telehua/NotLink_v6/docs/SCH_NotLink_v6_0.pdf

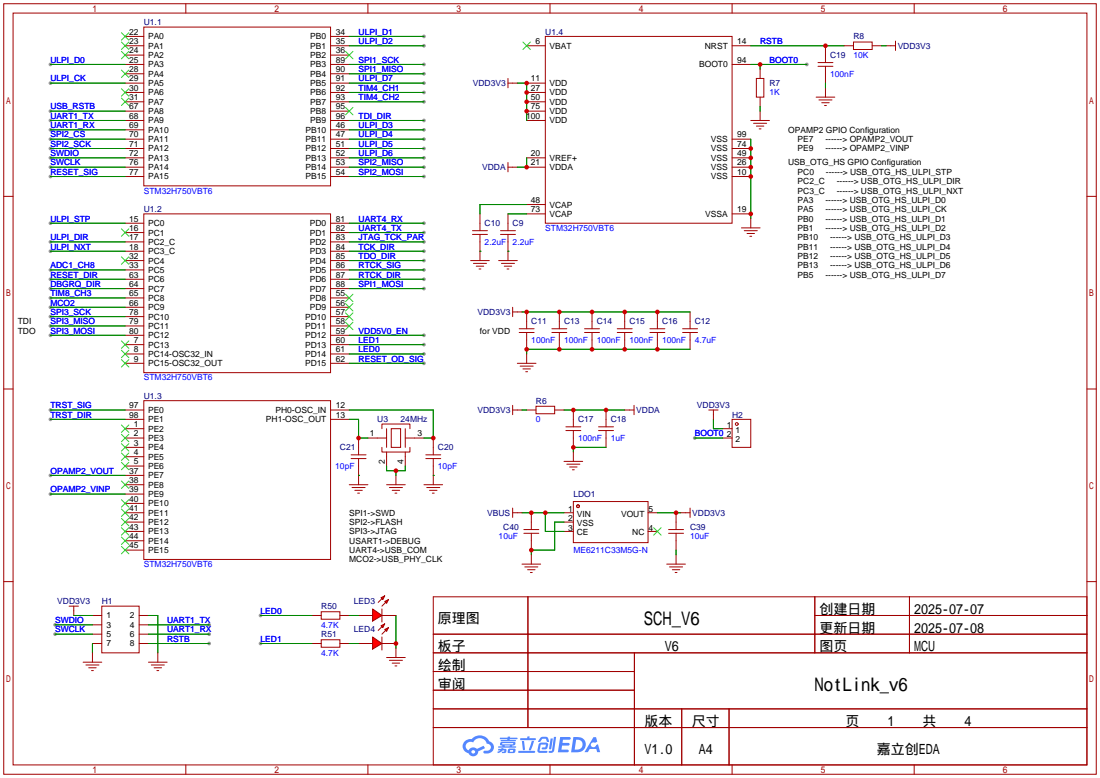
[picture p1: page 1]

原理图 | SCH_V6 | 创建日期 | 2025-07-07

更新日期 | 2025-07-08

板子 | V6 | 图页 | MCU
绘制 | | NotLink_v6
审阅

V1.0 | A4 | 嘉立创EDA

# XI 28 VDDA¹⁸ ²⁹

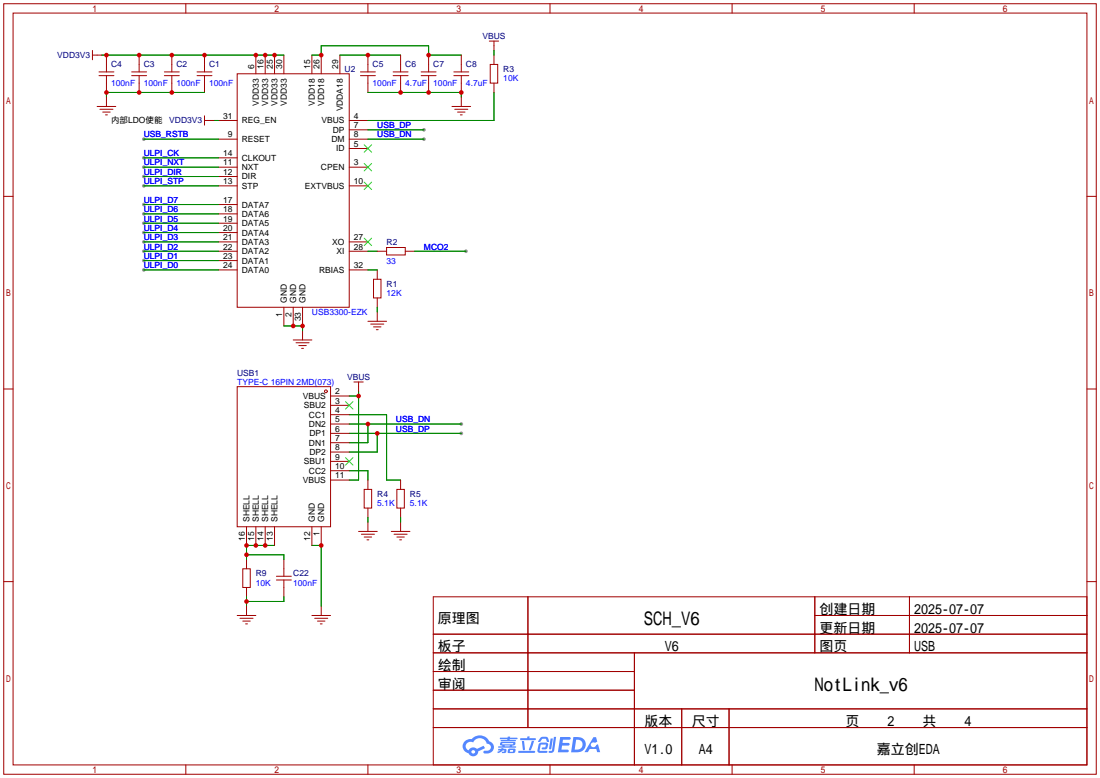
[picture p2: page 2]

SHELL 13 SHELL 14 SHELL 15 SHELL 16

原理图 | SCH_V6 | 创建日期 | 2025-07-07

更新日期 | 2025-07-07

板子 | V6 | 图页 | USB
绘制 | | NotLink_v6
审阅

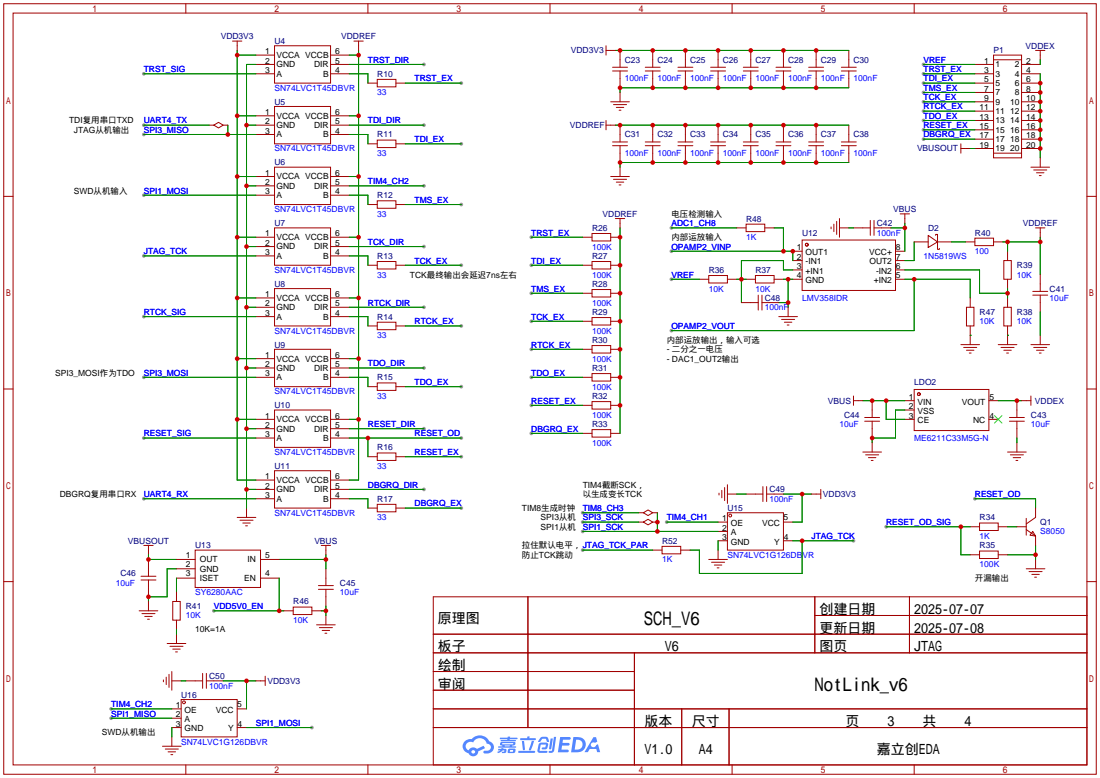
[picture p3: page 3]

原理图 | SCH_V6 | 创建日期 | 2025-07-07

更新日期 | 2025-07-08

板子 | V6 | 图页 | JTAG
绘制 | | NotLink_v6
审阅

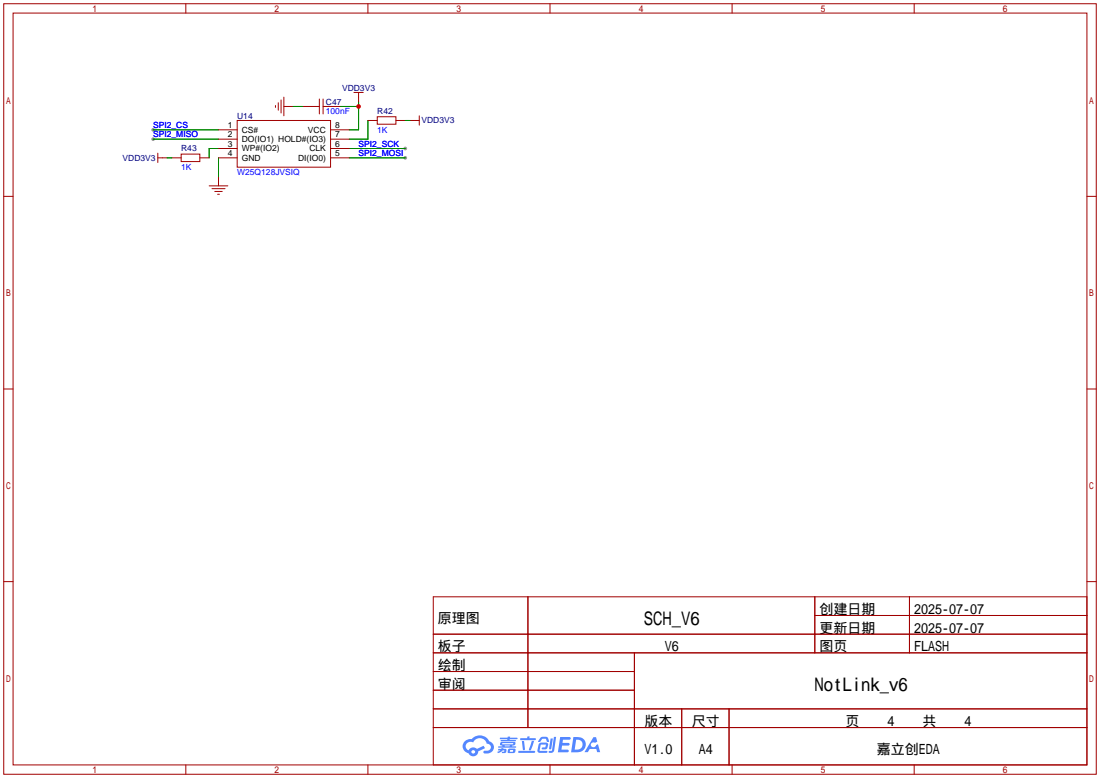
[picture p4: page 4]

原理图 | SCH_V6 | 创建日期 | 2025-07-07

更新日期 | 2025-07-07

板子 | V6 | 图页 | FLASH
绘制 | | NotLink_v6
审阅
