telehua/NotLink_v6/source/dap/dap.h

/*
 * Copyright (c) 2013-2022 ARM Limited. All rights reserved.
 *
 * SPDX-License-Identifier: Apache-2.0
 *
 * Licensed under the Apache License, Version 2.0 (the License); you may
 * not use this file except in compliance with the License.
 * You may obtain a copy of the License at
 *
 * www.apache.org/licenses/LICENSE-2.0
 *
 * Unless required by applicable law or agreed to in writing, software
 * distributed under the License is distributed on an AS IS BASIS, WITHOUT
 * WARRANTIES OR CONDITIONS OF ANY KIND, either express or implied.
 * See the License for the specific language governing permissions and
 * limitations under the License.
 *
 * ----------------------------------------------------------------------
 *
 * $Date:        5. December 2022
 * $Revision:    V2.1.2
 *
 * Project:      CMSIS-DAP Include
 * Title:        dap.h Definitions
 *
 *---------------------------------------------------------------------------*/

#ifndef __DAP_H__
#define __DAP_H__

// clang-format off

// DAP Firmware Version
#ifdef DAP_FW_V1
#define DAP_FW_VER "1.3.0"
#else
#define DAP_FW_VER "2.1.2"
#endif

// DAP Command IDs
#define ID_DAP_Info                 0x00U // 获取设备信息
#define ID_DAP_HostStatus           0x01U // 设定LED状态
#define ID_DAP_Connect              0x02U // 打开接口
#define ID_DAP_Disconnect           0x03U // 关闭接口
#define ID_DAP_TransferConfigure    0x04U // 配置传输参数
#define ID_DAP_Transfer             0x05U // 传输
#define ID_DAP_TransferBlock        0x06U // 块传输
#define ID_DAP_TransferAbort        0x07U // 
#define ID_DAP_WriteABORT           0x08U // 写停止寄存器
#define ID_DAP_Delay                0x09U // 延时
#define ID_DAP_ResetTarget          0x0AU // 复位目标芯片
#define ID_DAP_SWJ_Pins             0x10U // 软件IO设置
#define ID_DAP_SWJ_Clock            0x11U // 时钟速度
#define ID_DAP_SWJ_Sequence         0x12U // 序列
#define ID_DAP_SWD_Configure        0x13U // SWD配置
#define ID_DAP_SWD_Sequence         0x1DU // SWD序列
#define ID_DAP_JTAG_Sequence        0x14U // JTAG序列
#define ID_DAP_JTAG_Configure       0x15U // JTAG配置
#define ID_DAP_JTAG_IDCODE          0x16U // JTAG读IDCODE
#define ID_DAP_SWO_Transport        0x17U // 
#define ID_DAP_SWO_Mode             0x18U // 
#define ID_DAP_SWO_Baudrate         0x19U // 
#define ID_DAP_SWO_Control          0x1AU // 
#define ID_DAP_SWO_Status           0x1BU // 
#define ID_DAP_SWO_ExtendedStatus   0x1EU // 
#define ID_DAP_SWO_Data             0x1CU // 
#define ID_DAP_UART_Transport       0x1FU // 
#define ID_DAP_UART_Configure       0x20U // 
#define ID_DAP_UART_Control         0x22U // 
#define ID_DAP_UART_Status          0x23U // 
#define ID_DAP_UART_Transfer        0x21U // 

#define ID_DAP_QueueCommands        0x7EU // 顺序执行个操作
#define ID_DAP_ExecuteCommands      0x7FU // 执行单个操作

// DAP Vendor Command IDs
#define ID_DAP_Vendor0      0x80U
#define ID_DAP_Vendor1      0x81U
#define ID_DAP_Vendor2      0x82U
#define ID_DAP_Vendor3      0x83U
#define ID_DAP_Vendor4      0x84U
#define ID_DAP_Vendor5      0x85U
#define ID_DAP_Vendor6      0x86U
#define ID_DAP_Vendor7      0x87U
#define ID_DAP_Vendor8      0x88U
#define ID_DAP_Vendor9      0x89U
#define ID_DAP_Vendor10     0x8AU
#define ID_DAP_Vendor11     0x8BU
#define ID_DAP_Vendor12     0x8CU
#define ID_DAP_Vendor13     0x8DU
#define ID_DAP_Vendor14     0x8EU
#define ID_DAP_Vendor15     0x8FU
#define ID_DAP_Vendor16     0x90U
#define ID_DAP_Vendor17     0x91U
#define ID_DAP_Vendor18     0x92U
#define ID_DAP_Vendor19     0x93U
#define ID_DAP_Vendor20     0x94U
#define ID_DAP_Vendor21     0x95U
#define ID_DAP_Vendor22     0x96U
#define ID_DAP_Vendor23     0x97U
#define ID_DAP_Vendor24     0x98U
#define ID_DAP_Vendor25     0x99U
#define ID_DAP_Vendor26     0x9AU
#define ID_DAP_Vendor27     0x9BU
#define ID_DAP_Vendor28     0x9CU
#define ID_DAP_Vendor29     0x9DU
#define ID_DAP_Vendor30     0x9EU
#define ID_DAP_Vendor31     0x9FU

#define ID_DAP_Invalid      0xFFU

// DAP Status Code
#define DAP_OK      0U
#define DAP_ERROR   0xFFU

// DAP ID
#define DAP_ID_VENDOR               0x01U // 厂家
#define DAP_ID_PRODUCT              0x02U // 产品
#define DAP_ID_SER_NUM              0x03U // 序列号
#define DAP_ID_DAP_FW_VER           0x04U // 固件版本
#define DAP_ID_DEVICE_VENDOR        0x05U // 设备厂家
#define DAP_ID_DEVICE_NAME          0x06U // 设备名
#define DAP_ID_BOARD_VENDOR         0x07U // 板厂家
#define DAP_ID_BOARD_NAME           0x08U // 板名
#define DAP_ID_PRODUCT_FW_VER       0x09U // 产品版本
#define DAP_ID_CAPABILITIES         0xF0U // 可用功能
#define DAP_ID_TIMESTAMP_CLOCK      0xF1U // 时间戳计数频率
#define DAP_ID_UART_RX_BUFFER_SIZE  0xFBU // UART接收缓冲区大小
#define DAP_ID_UART_TX_BUFFER_SIZE  0xFCU // UART发送缓冲区大小
#define DAP_ID_SWO_BUFFER_SIZE      0xFDU // SWO缓冲区大小
#define DAP_ID_PACKET_COUNT         0xFEU // 包缓存个数
#define DAP_ID_PACKET_SIZE          0xFFU // 最大包长

// DAP Host Status
#define DAP_DEBUGGER_CONNECTED  0U
#define DAP_TARGET_RUNNING      1U

// DAP Port
#define DAP_PORT_AUTODETECT     0U // 自动 Autodetect Port 
#define DAP_PORT_DISABLED       0U // 高阻 Port Disabled (I/O pins in High-Z) 
#define DAP_PORT_SWD            1U // SWD Port (SWCLK, SWDIO) + nRESET
#define DAP_PORT_JTAG           2U // JTAG Port (TCK, TMS, TDI, TDO, nTRST) + nRESET

// DAP SWJ Pins
#define DAP_SWJ_SWCLK_TCK   0 // SWCLK/TCK
#define DAP_SWJ_SWDIO_TMS   1 // SWDIO/TMS
#define DAP_SWJ_TDI         2 // TDI
#define DAP_SWJ_TDO         3 // TDO
#define DAP_SWJ_nTRST       5 // nTRST
#define DAP_SWJ_nRESET      7 // nRESET

// DAP Transfer Request
#define DAP_TRANSFER_APnDP          (1U << 0)
#define DAP_TRANSFER_RnW            (1U << 1)
#define DAP_TRANSFER_A2             (1U << 2)
#define DAP_TRANSFER_A3             (1U << 3)
#define DAP_TRANSFER_MATCH_VALUE    (1U << 4)
#define DAP_TRANSFER_MATCH_MASK     (1U << 5)
#define DAP_TRANSFER_TIMESTAMP      (1U << 7)

// DAP Transfer Response
#define DAP_TRANSFER_OK         (1U << 0)
#define DAP_TRANSFER_WAIT       (1U << 1)
#define DAP_TRANSFER_FAULT      (1U << 2)
#define DAP_TRANSFER_ERROR      (1U << 3)
#define DAP_TRANSFER_MISMATCH   (1U << 4)

// DAP SWO Trace Mode
#define DAP_SWO_OFF         0U
#define DAP_SWO_UART        1U
#define DAP_SWO_MANCHESTER  2U

// DAP SWO Trace Status
#define DAP_SWO_CAPTURE_ACTIVE  (1U << 0)
#define DAP_SWO_CAPTURE_PAUSED  (1U << 1)
#define DAP_SWO_STREAM_ERROR    (1U << 6)
#define DAP_SWO_BUFFER_OVERRUN  (1U << 7)

// DAP UART Transport
#define DAP_UART_TRANSPORT_NONE         0U
#define DAP_UART_TRANSPORT_USB_COM_PORT 1U
#define DAP_UART_TRANSPORT_DAP_COMMAND  2U

// DAP UART Control
#define DAP_UART_CONTROL_RX_ENABLE      (1U << 0)
#define DAP_UART_CONTROL_RX_DISABLE     (1U << 1)
#define DAP_UART_CONTROL_RX_BUF_FLUSH   (1U << 2)
#define DAP_UART_CONTROL_TX_ENABLE      (1U << 4)
#define DAP_UART_CONTROL_TX_DISABLE     (1U << 5)
#define DAP_UART_CONTROL_TX_BUF_FLUSH   (1U << 6)

// DAP UART Status
#define DAP_UART_STATUS_RX_ENABLED      (1U << 0)
#define DAP_UART_STATUS_RX_DATA_LOST    (1U << 1)
#define DAP_UART_STATUS_FRAMING_ERROR   (1U << 2)
#define DAP_UART_STATUS_PARITY_ERROR    (1U << 3)
#define DAP_UART_STATUS_TX_ENABLED      (1U << 4)

// DAP UART Configure Error
#define DAP_UART_CFG_ERROR_DATA_BITS    (1U << 0)
#define DAP_UART_CFG_ERROR_PARITY       (1U << 1)
#define DAP_UART_CFG_ERROR_STOP_BITS    (1U << 2)

// Debug Port Register Addresses
#define DP_IDCODE           0x00U // IDCODE Register (SW Read only)
#define DP_ABORT            0x00U // Abort Register (SW Write only)
#define DP_CTRL_STAT        0x04U // Control & Status
#define DP_WCR              0x04U // Wire Control Register (SW Only)
#define DP_SELECT           0x08U // Select Register (JTAG R/W & SW W)
#define DP_RESEND           0x08U // Resend (SW Read Only)
#define DP_RDBUFF           0x0CU // Read Buffer (Read Only)

// JTAG IR Codes
#define JTAG_ABORT          0x08U
#define JTAG_DPACC          0x0AU
#define JTAG_APACC          0x0BU
#define JTAG_IDCODE         0x0EU
#define JTAG_BYPASS         0x0FU

// JTAG Sequence Info
#define JTAG_SEQUENCE_TCK   0x3FU // TCK count
#define JTAG_SEQUENCE_TMS   0x40U // TMS value
#define JTAG_SEQUENCE_TDO   0x80U // TDO capture

// SWD Sequence Info
#define SWD_SEQUENCE_CLK    0x3FU // SWCLK count
#define SWD_SEQUENCE_DIN    0x80U // SWDIO capture

// clang-format on

#include <stdbool.h>
#include <stddef.h>
#include <stdint.h>
#include <stdlib.h>

#include "cmsis_compiler.h"
#include "dap_config.h"

// clang-format off

// DAP Data structure
typedef struct
{
    uint32_t debug_port;    // 接口 Debug Port
    uint32_t clock_delay;   // Clock Delay
    uint32_t timestamp;     // 时间戳 Last captured Timestamp
    uint32_t gpio_mode;     // GPIO模式
    struct
    {                           // 传输配置 Transfer Configuration
        uint32_t idle_cycles;   // 传输后生成的空闲周期数(最大值255) Idle cycles after transfer
        uint32_t retry_count;   // ACK忙时重试次数(最大65535) Number of retries after WAIT response
        uint32_t match_retry;   // 匹配模式时重试次数(最大65535) Number of retries if read value does not match
        uint32_t match_mask;    // 匹配模式的掩码 Match Mask
    } transfer;
#if (DAP_SWD != 0)
    struct                      
    {                           // SWD配置 SWD Configuration
        uint32_t turnaround;    // 方向转换时插入的周期数(最大值4) Turnaround period
        uint32_t data_phase;    // 是否始终生成数据阶段 Always generate Data Phase
    } swd_conf;
#endif
#if (DAP_JTAG != 0)
    struct
    {                       // JTAG Device Chain
        uint32_t count;     // 线上的设备个数 Number of devices
        uint32_t index;     // 设备位置 Device index (device at TDO has index 0)
#if (DAP_JTAG_DEV_CNT != 0)
        uint32_t ir_length[DAP_JTAG_DEV_CNT];   // 每个设备的IR长度(255 max) IR Length in bits
        uint32_t ir_before[DAP_JTAG_DEV_CNT];   // 设备前方的IR长度 Bits before IR
        uint32_t ir_after[DAP_JTAG_DEV_CNT];    // 设备后方的IR长度 Bits after IR
#endif
    } jtag_dev;
#endif
} dap_data_t;

// clang-format on

extern dap_data_t dap_data;                 // DAP Data
extern volatile uint8_t dap_transfer_abort; // Transfer Abort Flag

#ifdef __cplusplus
extern "C"
{
#endif

#if (SWO_UART != 0)
    extern uint32_t SWO_Transport(const uint8_t *request, uint8_t *response);
    extern uint32_t SWO_Mode(const uint8_t *request, uint8_t *response);
    extern uint32_t SWO_Baudrate(const uint8_t *request, uint8_t *response);
    extern uint32_t SWO_Control(const uint8_t *request, uint8_t *response);
    extern uint32_t SWO_Status(uint8_t *response);
    extern uint32_t SWO_ExtendedStatus(const uint8_t *request, uint8_t *response);
    extern uint32_t SWO_Data(const uint8_t *request, uint8_t *response);

    extern void SWO_QueueTransfer(uint8_t *buf, uint32_t num);
    extern void SWO_AbortTransfer(void);
    extern void SWO_TransferComplete(void);

    extern uint32_t SWO_Mode_UART(uint32_t enable);
    extern uint32_t SWO_Baudrate_UART(uint32_t baudrate);
    extern uint32_t SWO_Control_UART(uint32_t active);
    extern void SWO_Capture_UART(uint8_t *buf, uint32_t num);
    extern uint32_t SWO_GetCount_UART(void);

    extern uint32_t SWO_Mode_Manchester(uint32_t enable);
    extern uint32_t SWO_Baudrate_Manchester(uint32_t baudrate);
    extern uint32_t SWO_Control_Manchester(uint32_t active);
    extern void SWO_Capture_Manchester(uint8_t *buf, uint32_t num);
    extern uint32_t SWO_GetCount_Manchester(void);
#endif

#if (DAP_UART != 0)
    extern uint32_t UART_Transport(const uint8_t *request, uint8_t *response);
    extern uint32_t UART_Configure(const uint8_t *request, uint8_t *response);
    extern uint32_t UART_Control(const uint8_t *request, uint8_t *response);
    extern uint32_t UART_Status(uint8_t *response);
    extern uint32_t UART_Transfer(const uint8_t *request, uint8_t *response);
    extern uint8_t USB_COM_PORT_Activate(uint32_t cmd);
#endif

    uint32_t DAP_ProcessVendorCommand(const uint8_t *request, uint8_t *response);
    uint32_t DAP_ProcessCommand(const uint8_t *request, uint8_t *response);
    uint32_t DAP_ExecuteCommand(const uint8_t *request, uint8_t *response);

    void DAP_Setup(void);
    void bsp_jtag_check_gpio_mode(uint32_t mode);

    uint8_t DAP_GetVendorString(char *str);
    uint8_t DAP_GetProductString(char *str);
    uint8_t DAP_GetSerNumString(char *str);

#ifdef __cplusplus
}
#endif

#endif /* __DAP_H__ */
