telehua/NotLink_v6/source/app_rtos/config.h

#ifndef __CONFIG_H__
#define __CONFIG_H__

// 编译选项
#define CONFIG_BUILD_TIME (__DATE__ " " __TIME__)

// 编译选项
#define CONFIG_BUILD_TYPE "Release"

// 编译器版本
#define CONFIG_C_COMPILER_VERSION "14.2.1"

#endif /* __CONFIG_H__ */
