telehua/NotLink_v6/source/bsp/bsp.h

#ifndef __BSP_H__
#define __BSP_H__

#include "bsp_crc.h"
#include "bsp_debug.h"
#include "bsp_jtag.h"
#include "bsp_led.h"
#include "bsp_spi.h"
#include "bsp_tick.h"
#include "bsp_usb.h"
#include "bsp_vcom.h"
#include "bsp_vee.h"

#define ITCM __attribute__((section(".itcm")))

#endif /* __BSP_H__ */
