telehua/NotLink_v6/(commit log)

2025-09-02 初始提交
2025-09-06 修改MPU配置
2025-09-06 修改GPIO模式检查
2025-09-07 修改烧录算法
